wilywyrm/nixiedice/README.md

# nixiedice
Glorified RNG using a Nixie display and pretty LEDs
