wilywyrm/nixiedice/(list of files, drawings)

Other design files:
nixiedice.dsn
