wilywyrm/nixiedice/nixiedice.kicad_pcb

## KiCad design nixiedice.kicad_pcb (2017-02-08)

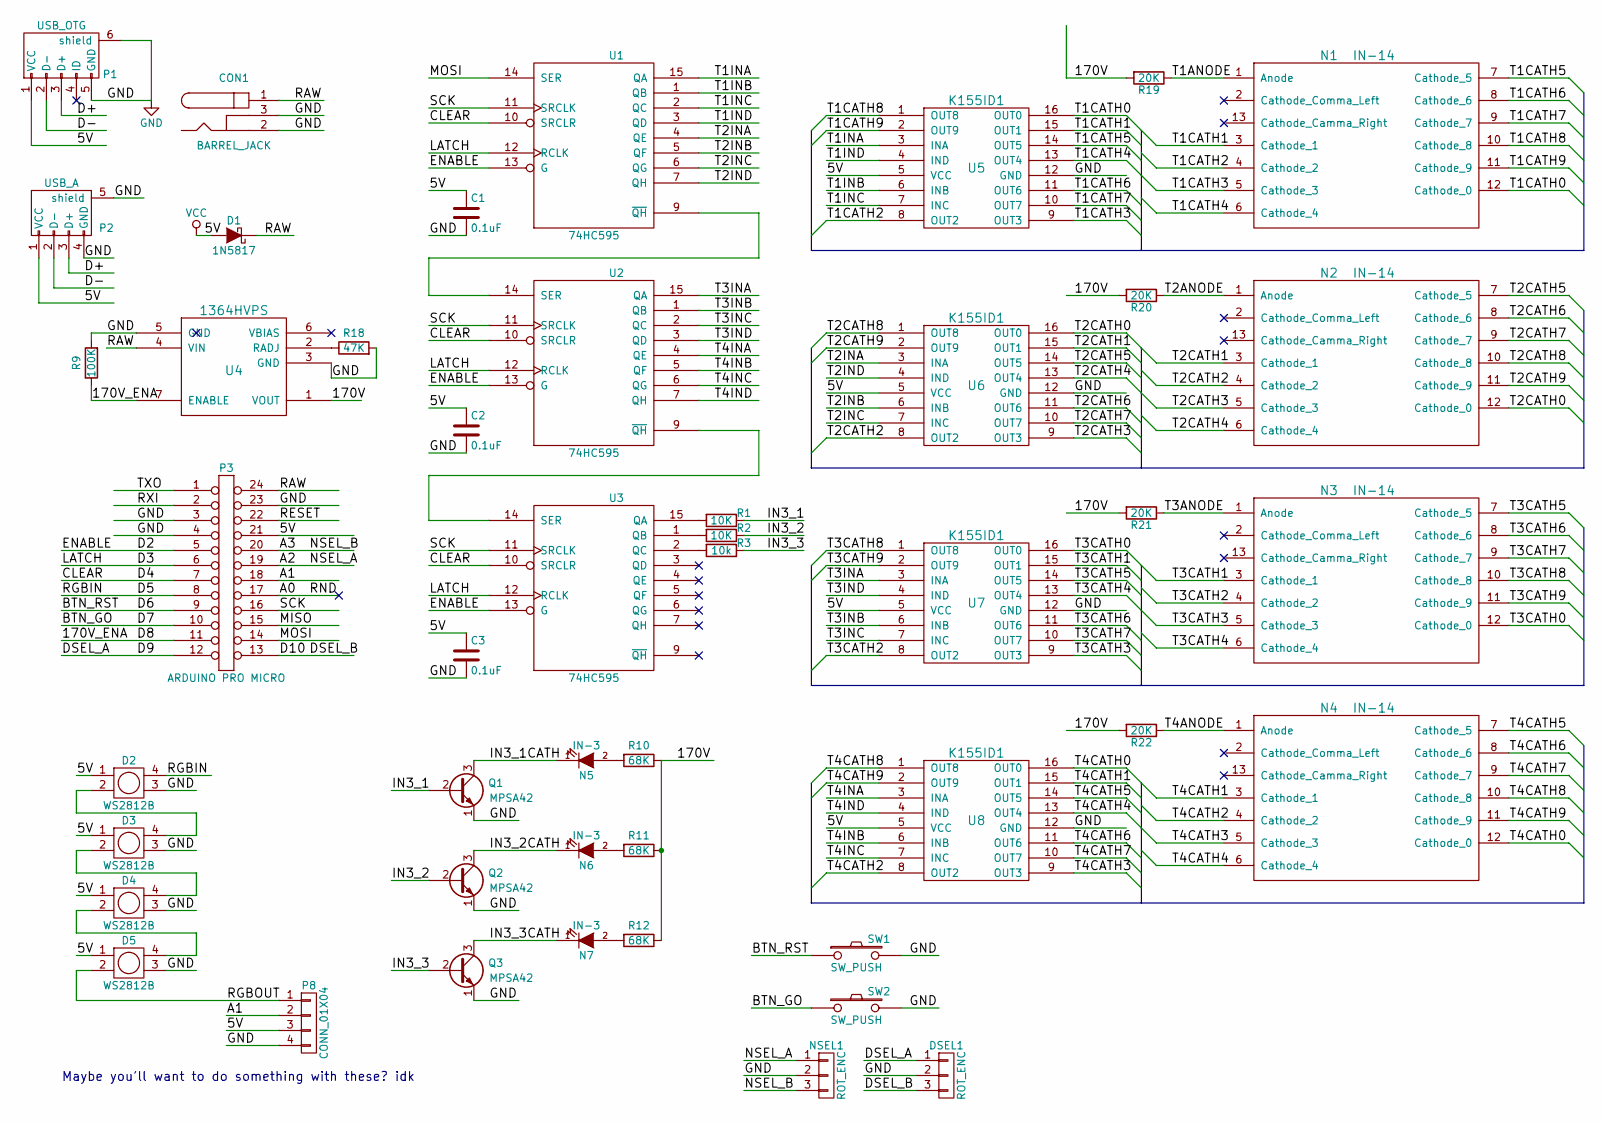
[picture p1: schematic nixiedice.sch]

Parts:
C1, C2, C3: 0.1uF; C_Disc_D3_P2.5
CON1: BARREL_JACK
D1: 1N5817; DO-41
D2, D3, D4, D5: WS2812B; LED_WS2812B-PLCC4
DSEL1: ROT_ENC; Socket_Strip_Straight_1x03
N1, N2, N3, N4: IN-14
N5, N6, N7: IN-3
NSEL1: ROT_ENC; Socket_Strip_Straight_1x03
P1: USB_OTG; USB_Micro-B
P2: USB_A
P3: ARDUINO PRO MICRO; Pro_Micro
P8: CONN_01X04; Socket_Strip_Straight_1x04
Q1, Q2, Q3: MPSA42; TO-92_Inline_Wide
R1, R2: 10K; R3
R3: 10k; R3
R9: 100K; R3
R10, R11, R12: 68K; R3
R18: 47K; R3
R19, R20, R21, R22: 20K; R3
SW1, SW2: SW_PUSH; CHERRY_PCB_100H
U1, U2, U3: 74HC595; SOIC-16_3.9x9.9mm_Pitch1.27mm
U4: 1364HVPS
U5, U6, U7, U8: K155ID1; DIP-16_W7.62mm_LongPads

Connections:
/170V: R10.1, R11.1, R12.1, R19.2, R20.2, R21.2, R22.2, U4.1 (VOUT)
/170V_ENA: P3.11, R9.1, U4.7 (ENABLE)
/A0: P3.17
/A1: P3.18, P8.2
/A2: NSEL1.1, P3.19
/A3: NSEL1.3, P3.20
/BTN_GO: P3.10, SW2.1
/BTN_RST: P3.9, SW1.1
/CLEAR: P3.7, U1.10 (SRCLR), U2.10 (SRCLR), U3.10 (SRCLR)
/D2: P3.5, U1.13 (G), U2.13 (G), U3.13 (G)
/D3: P3.6, U1.12 (RCLK), U2.12 (RCLK), U3.12 (RCLK)
/D5: D2.4 (P2), P3.8
/D9: DSEL1.1, P3.12
/D10: DSEL1.3, P3.13
/D+: P1.3 (D+), P2.3 (D+)
/D-: P1.2 (D-), P2.2 (D-)
/IN3_1: Q1.2 (B), R1.1
/IN3_1CATH: N5.1 (K), Q1.3 (C)
/IN3_2: Q2.2 (B), R2.1
/IN3_2CATH: N6.1 (K), Q2.3 (C)
/IN3_3: Q3.2 (B), R3.1
/IN3_3CATH: N7.1 (K), Q3.3 (C)
/MISO: P3.15
/MOSI: P3.14, U1.14 (SER)
/RAW: CON1.1, D1.1 (K), P3.24, U4.4 (VIN)
/RESET: P3.22
/RGBOUT: D5.2 (P3), P8.1
/RXI: P3.2
/SCK: P3.16, U1.11 (SRCLK), U2.11 (SRCLK), U3.11 (SRCLK)
/T1ANODE: N1.1 (Anode), R19.1
/T1CATH0: N1.12 (Cathode_0), U5.16 (OUT0)
/T1CATH1: N1.3 (Cathode_1), U5.15 (OUT1)
/T1CATH2: N1.4 (Cathode_2), U5.8 (OUT2)
/T1CATH3: N1.5 (Cathode_3), U5.9 (OUT3)
/T1CATH4: N1.6 (Cathode_4), U5.13 (OUT4)
/T1CATH5: N1.7 (Cathode_5), U5.14 (OUT5)
/T1CATH6: N1.8 (Cathode_6), U5.11 (OUT6)
/T1CATH7: N1.9 (Cathode_7), U5.10 (OUT7)
/T1CATH8: N1.10 (Cathode_8), U5.1 (OUT8)
/T1CATH9: N1.11 (Cathode_9), U5.2 (OUT9)
/T1INA: U1.15 (QA), U5.3 (INA)
/T1INB: U1.1 (QB), U5.6 (INB)
/T1INC: U1.2 (QC), U5.7 (INC)
/T1IND: U1.3 (QD), U5.4 (IND)
/T2ANODE: N2.1 (Anode), R20.1
/T2CATH0: N2.12 (Cathode_0), U6.16 (OUT0)
/T2CATH1: N2.3 (Cathode_1), U6.15 (OUT1)
/T2CATH2: N2.4 (Cathode_2), U6.8 (OUT2)
/T2CATH3: N2.5 (Cathode_3), U6.9 (OUT3)
/T2CATH4: N2.6 (Cathode_4), U6.13 (OUT4)
/T2CATH5: N2.7 (Cathode_5), U6.14 (OUT5)
/T2CATH6: N2.8 (Cathode_6), U6.11 (OUT6)
/T2CATH7: N2.9 (Cathode_7), U6.10 (OUT7)
/T2CATH8: N2.10 (Cathode_8), U6.1 (OUT8)
/T2CATH9: N2.11 (Cathode_9), U6.2 (OUT9)
/T2INA: U1.4 (QE), U6.3 (INA)
/T2INB: U1.5 (QF), U6.6 (INB)
/T2INC: U1.6 (QG), U6.7 (INC)
/T2IND: U1.7 (QH), U6.4 (IND)
/T3ANODE: N3.1 (Anode), R21.1
/T3CATH0: N3.12 (Cathode_0), U7.16 (OUT0)
/T3CATH1: N3.3 (Cathode_1), U7.15 (OUT1)
/T3CATH2: N3.4 (Cathode_2), U7.8 (OUT2)
/T3CATH3: N3.5 (Cathode_3), U7.9 (OUT3)
/T3CATH4: N3.6 (Cathode_4), U7.13 (OUT4)
/T3CATH5: N3.7 (Cathode_5), U7.14 (OUT5)
/T3CATH6: N3.8 (Cathode_6), U7.11 (OUT6)
/T3CATH7: N3.9 (Cathode_7), U7.10 (OUT7)
/T3CATH8: N3.10 (Cathode_8), U7.1 (OUT8)
/T3CATH9: N3.11 (Cathode_9), U7.2 (OUT9)
/T3INA: U2.15 (QA), U7.3 (INA)
/T3INB: U2.1 (QB), U7.6 (INB)
/T3INC: U2.2 (QC), U7.7 (INC)
/T3IND: U2.3 (QD), U7.4 (IND)
/T4ANODE: N4.1 (Anode), R22.1
/T4CATH0: N4.12 (Cathode_0), U8.16 (OUT0)
/T4CATH1: N4.3 (Cathode_1), U8.15 (OUT1)
/T4CATH2: N4.4 (Cathode_2), U8.8 (OUT2)
/T4CATH3: N4.5 (Cathode_3), U8.9 (OUT3)
/T4CATH4: N4.6 (Cathode_4), U8.13 (OUT4)
/T4CATH5: N4.7 (Cathode_5), U8.14 (OUT5)
/T4CATH6: N4.8 (Cathode_6), U8.11 (OUT6)
/T4CATH7: N4.9 (Cathode_7), U8.10 (OUT7)
/T4CATH8: N4.10 (Cathode_8), U8.1 (OUT8)
/T4CATH9: N4.11 (Cathode_9), U8.2 (OUT9)
/T4INA: U2.4 (QE), U8.3 (INA)
/T4INB: U2.5 (QF), U8.6 (INB)
/T4INC: U2.6 (QG), U8.7 (INC)
/T4IND: U2.7 (QH), U8.4 (IND)
/TXO: P3.1
GND: C1.2, C2.2, C3.2, CON1.2, CON1.3, D2.3 (P4), D3.3 (P4), D4.3 (P4), D5.3 (P4), DSEL1.2, NSEL1.2, P1.5 (GND), P1.6 (shield), P2.4 (GND), P2.5 (shield), P3.3, P3.4, P3.23, P8.4, Q1.1 (E), Q2.1 (E), Q3.1 (E), R9.2, R18.2, SW1.2, SW2.2, U1.8 (GND), U2.8 (GND), U3.8 (GND), U4.3 (GND), U4.5 (GND), U5.12 (GND), U6.12 (GND), U7.12 (GND), U8.12 (GND)
unnamed: D2.2 (P3), D3.4 (P2)
unnamed: D3.2 (P3), D4.4 (P2)
unnamed: D4.2 (P3), D5.4 (P2)
unnamed: N5.2 (A), R10.2
unnamed: N6.2 (A), R11.2
unnamed: N7.2 (A), R12.2
unnamed: R1.2, U3.15 (QA)
unnamed: R2.2, U3.1 (QB)
unnamed: R3.2, U3.2 (QC)
unnamed: R18.1, U4.2 (RADJ)
unnamed: U1.9 (~QH), U2.14 (SER)
unnamed: U2.9 (~QH), U3.14 (SER)
VCC: C1.1, C2.1, C3.1, D1.2 (A), D2.1, D3.1, D4.1, D5.1, P1.1 (VCC), P2.1 (VCC), P3.21, P8.3, U1.16 (VCC), U2.16 (VCC), U3.16 (VCC), U5.5 (VCC), U6.5 (VCC), U7.5 (VCC), U8.5 (VCC)

Notes on the sheet:
Maybe you'll want to do something with these? idk

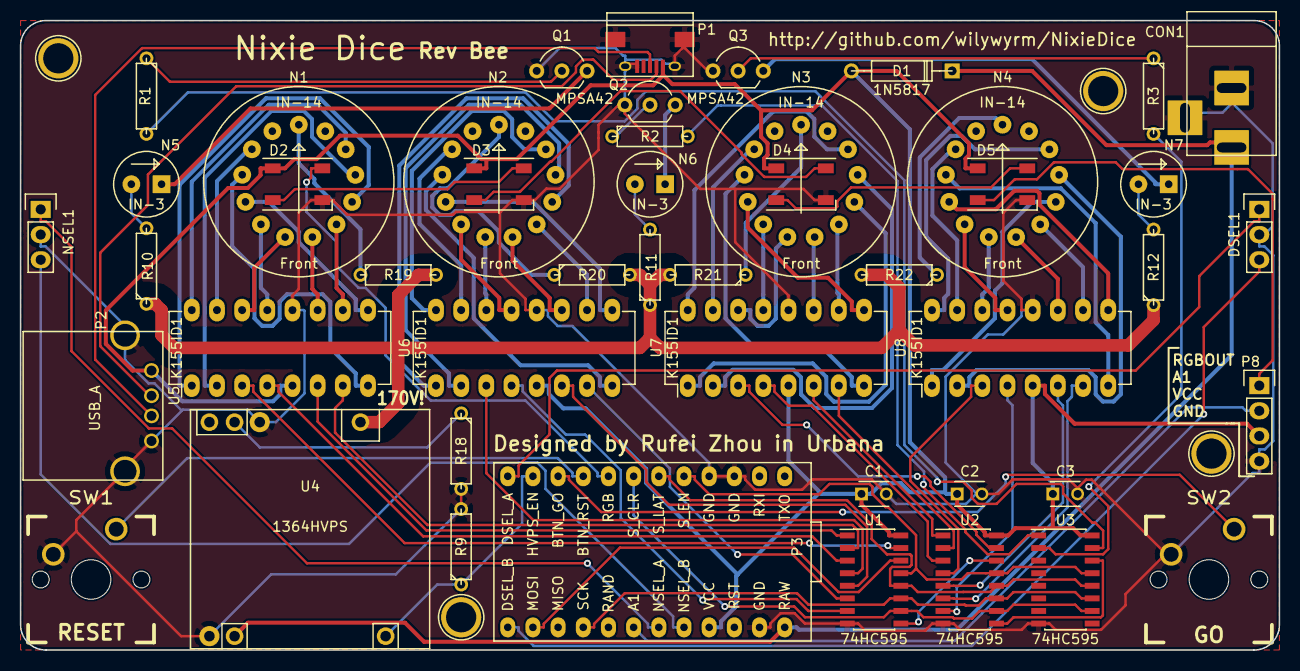
[picture p2: board nixiedice.kicad_pcb from above]

Board: 2 copper layers, 127.0 x 63.5 mm, 51 parts (0 on the bottom side), 99 nets.

Other parts of the board:
M1, M2, M3, M4: 1pin
