wilywyrm/nixiedice/(commit log)

2017-01-03 fix sleep color
    it is no longer (b,0,0) all over me
    [nixiedice.ino]
2017-01-05 fix IN-14 footprint being upside down
    ussr datasheet is backwards af
    [nixiedice-B.Cu.gbr, nixiedice-B.Mask.gbr, nixiedice-B.SilkS.gbr, nixiedice-Edge.Cuts.gbr, nixiedice-F.Cu.gbr, nixiedice-F.Mask.gbr, nixiedice-F.SilkS.gbr, nixiedice-NPTH.drl]
2017-01-05 fix indicator IN3 not working
    forgot how to bitwise clear
    also roughly synchronize LED theatre chase with IN3 indicator theatre
    chase effect during dice roll
    [nixiedice.ino]
2017-01-05 change microusb connector to use smd pads
    also add line on front silkscreen to plug this schweet repo
    [nixiedice-B.Cu.gbr, nixiedice-B.Mask.gbr, nixiedice-B.SilkS.gbr, nixiedice-Edge.Cuts.gbr, nixiedice-F.Cu.gbr, nixiedice-F.Mask.gbr, nixiedice-F.SilkS.gbr, nixiedice-NPTH.drl]
2017-01-06 update silkscreen
    [nixiedice-B.Cu.gbr, nixiedice-B.Mask.gbr, nixiedice-B.SilkS.gbr, nixiedice-Edge.Cuts.gbr, nixiedice-F.Cu.gbr, nixiedice-F.Mask.gbr, nixiedice-F.SilkS.gbr, nixiedice-NPTH.drl]
2017-01-06 switch mapping for rev A boards to work backwards
2017-01-14 bunch of fixes, tested with rev A board in hand
    - fix setDigit to use MSB order of K155ID1 driver chip while using LSB
    for everything else
    - fix setDigit not negating half of shift register byte
    - fix setAllDigits not separating digits of input properly
    - fix setIndicator not selecting correct indicator IN3
    - fix off by one errors in various indicator effects
    - fix maintenance mode not storing indicator IN3 state
    - add set/getRegValue for saving indicator IN3 state
    - adjust timings of indicator effects
    - switch button and sel pins to account for tubes being reversed
    [nixiedice.ino]
2017-01-14 fix maintenance mode crash
    - remove maintenance mode saving of indicator IN3 state, was forcing
    reset in middle of maintenance mode
    [nixiedice.ino]
2017-01-14 switch pins and effect offsets back for rev B
2017-01-14 fix indicator display while rolling
    [nixiedice.ino]
2017-02-08 emergency pcb silkscreen revision
    [_saved_nixiedice.sch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]
